Alirezagholizadehvazvani/industrial-motor-monitor/hardware/photos/01-complete-setup-failed-attempt.jpg

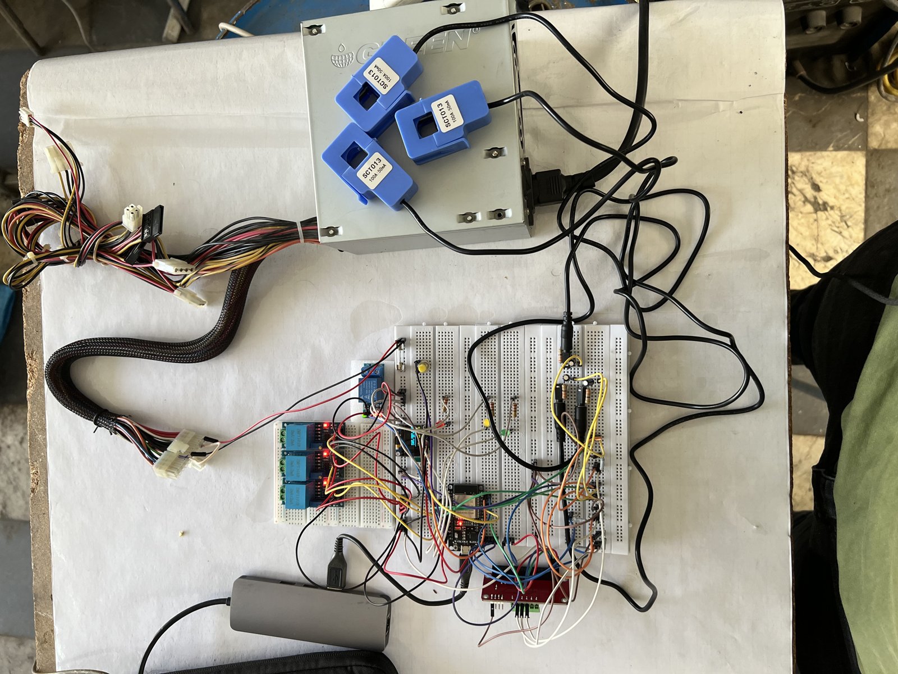
hardware/photos/01-complete-setup-failed-attempt.jpg
