Alirezagholizadehvazvani/industrial-motor-monitor/hardware/photos/01-socket-setup.jpg

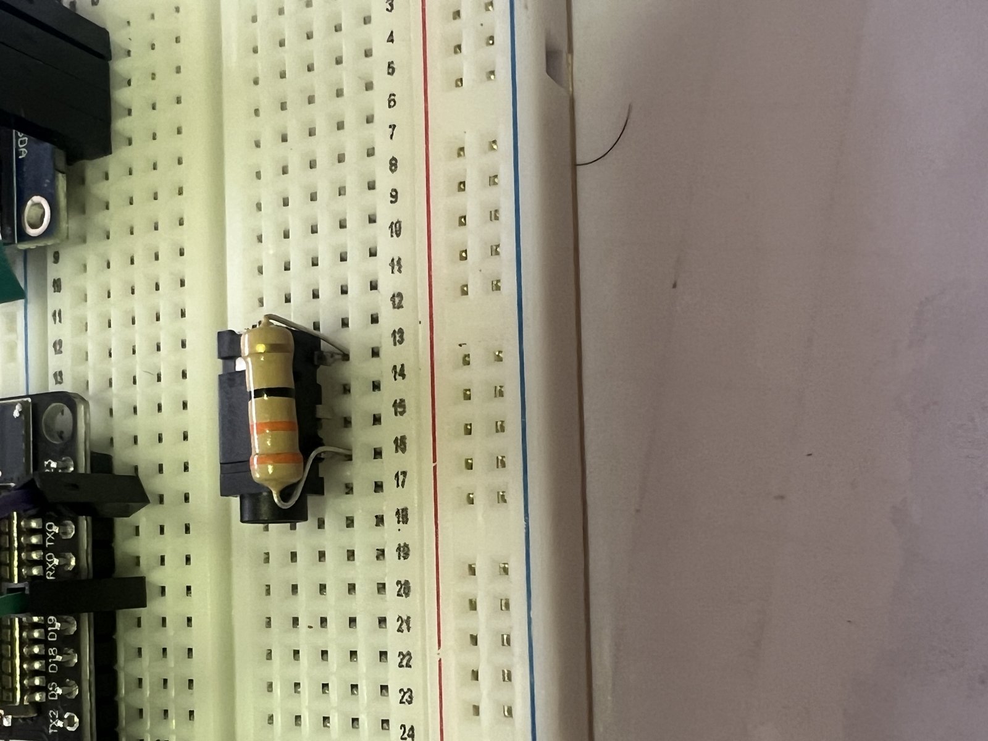
hardware/photos/01-socket-setup.jpg
