Alirezagholizadehvazvani/industrial-motor-monitor/hardware/photos/README.md

# Photos

Photos of the breadboard prototype and the enclosure during the build. Files are resized to 1600 px and carry no location data. The number prefixes come from the original file names. Dates were not recorded. Captions describe what is visible.

| File | Shows |
|---|---|
| `01-complete-setup-failed-attempt.jpg` | Breadboard build with the power supply and clamp-on current sensors, from the first attempt that did not work. |
| `01-components-boards.jpg` | Main boards: ESP32, relay module, three ZMPT101B modules, ADS1115 board and OLED. |
| `01-enclosure-cable-management.jpg` | Enclosure back plate with control wiring being organised. |
| `01-final-setup-failed.jpg` | Prototype wiring in the enclosure, version that failed. |
| `01-final-setup-fixed.jpg` | Breadboard prototype after the fix. |
| `01-new-wiring-method-fixed.jpg` | Breadboard rewired with the new method. The boxed area marks the changed section. |
| `01-noise-issue-fix.jpg` | Wiring in the enclosure while working on the noise problem. |
| `01-oled-test.jpg` | First bring-up of the OLED on the ESP32. |
| `01-phase0-failed-wiring.jpg` | Early breadboard wiring that did not work. |
| `01-power-circuit.jpg` | Power components on the DIN rail: breaker, starter and contactor. |
| `01-power-issue.jpg` | Power supply leads to the breadboard rails while tracing a power problem. |
| `01-sensor-readings-test.jpg` | OLED showing raw sensor readings. |
| `01-socket-setup.jpg` | Component fitted on the breadboard (sensor socket stage). |
| `01-status-test.jpg` | OLED showing STATUS: OK with current values. |
| `01-wiring-error.jpg` | Breadboard with the incorrect wiring areas marked in red. |
| `02-complete-setup-failed-attempt.jpg` | Second complete breadboard attempt with clamp-on sensors and the ADS1115 board. |
| `02-enclosure-cable-management.jpg` | Enclosure with the DIN rail components wired. |
| `02-power-circuit-contactor.jpg` | Hyundai HGC 25 contactor and the starter below it on the DIN rail. |
| `02-resistors.jpg` | Resistors, labelled by hand as 33 ohm 1 W, 220 ohm 2 W and 10 kohm 1 W. |
| `02-sensor-readings-test.jpg` | OLED showing three current-channel voltages of 1.56 V and three raw voltage-channel values. |
| `02-status-test.jpg` | OLED showing STATUS: OK. |
| `03-capacitors.jpg` | Capacitors, labelled by hand as 10 uF 25 V, 100 nF 400 V and 0.1 uF 50 V. |
| `03-status-test-tripped.jpg` | OLED showing STATUS: TRIPPED with the reset prompt, red LED on. |
