Alirezagholizadehvazvani/industrial-motor-monitor/hardware/photos/01-enclosure-cable-management.jpg

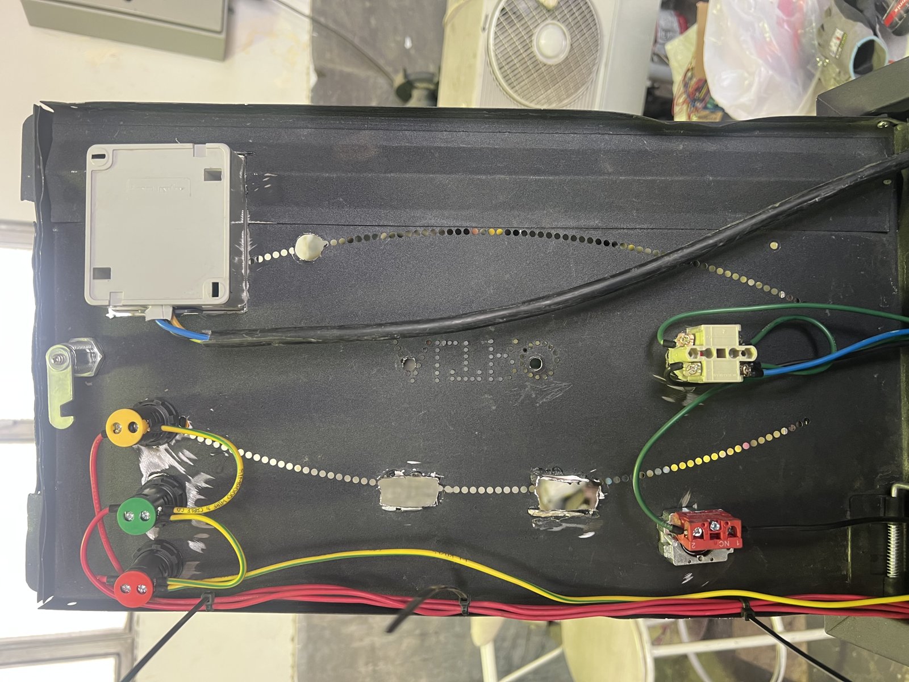
hardware/photos/01-enclosure-cable-management.jpg
