Alirezagholizadehvazvani/industrial-motor-monitor/hardware/photos/01-power-circuit.jpg

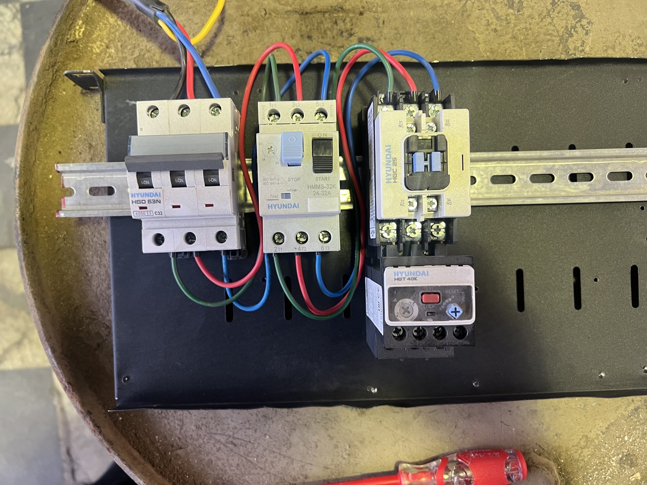
hardware/photos/01-power-circuit.jpg
