Alirezagholizadehvazvani/industrial-motor-monitor/hardware/photos/02-enclosure-cable-management.jpg

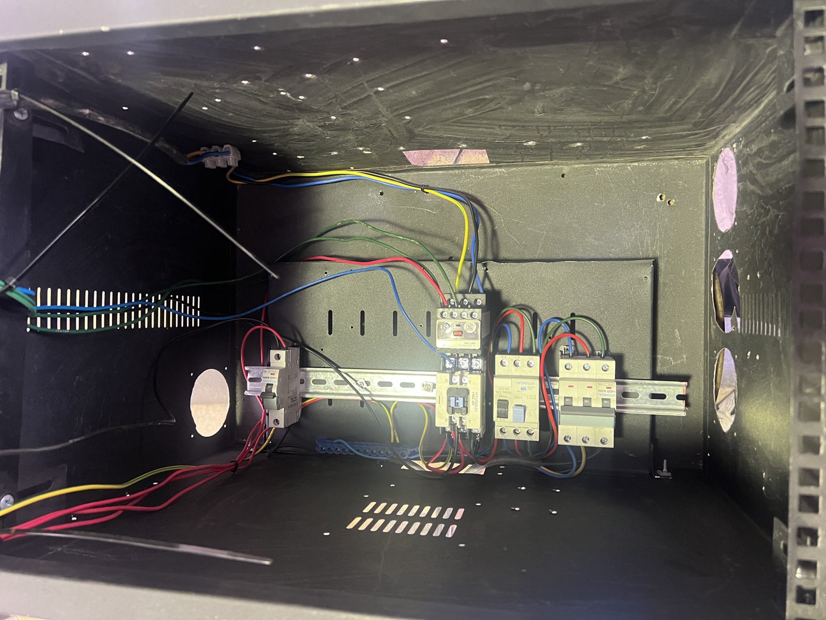
hardware/photos/02-enclosure-cable-management.jpg
