Alirezagholizadehvazvani/industrial-motor-monitor/hardware/photos/02-power-circuit-contactor.jpg

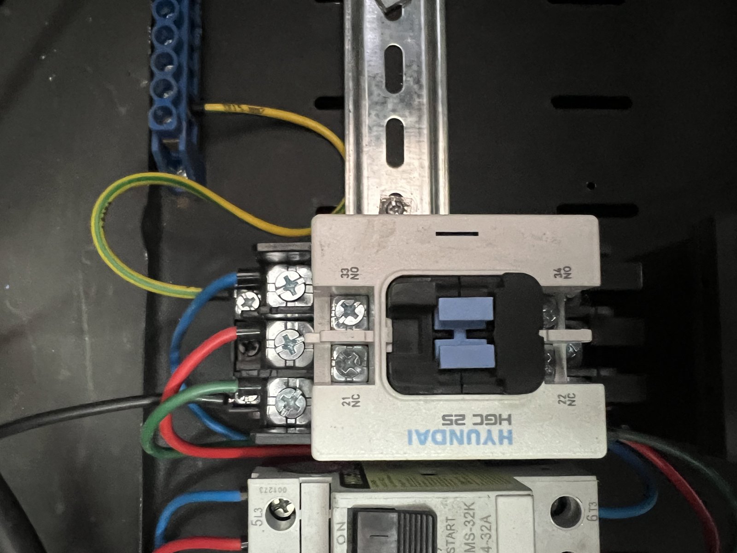
hardware/photos/02-power-circuit-contactor.jpg
