Alirezagholizadehvazvani/industrial-motor-monitor/hardware/photos/02-resistors.jpg

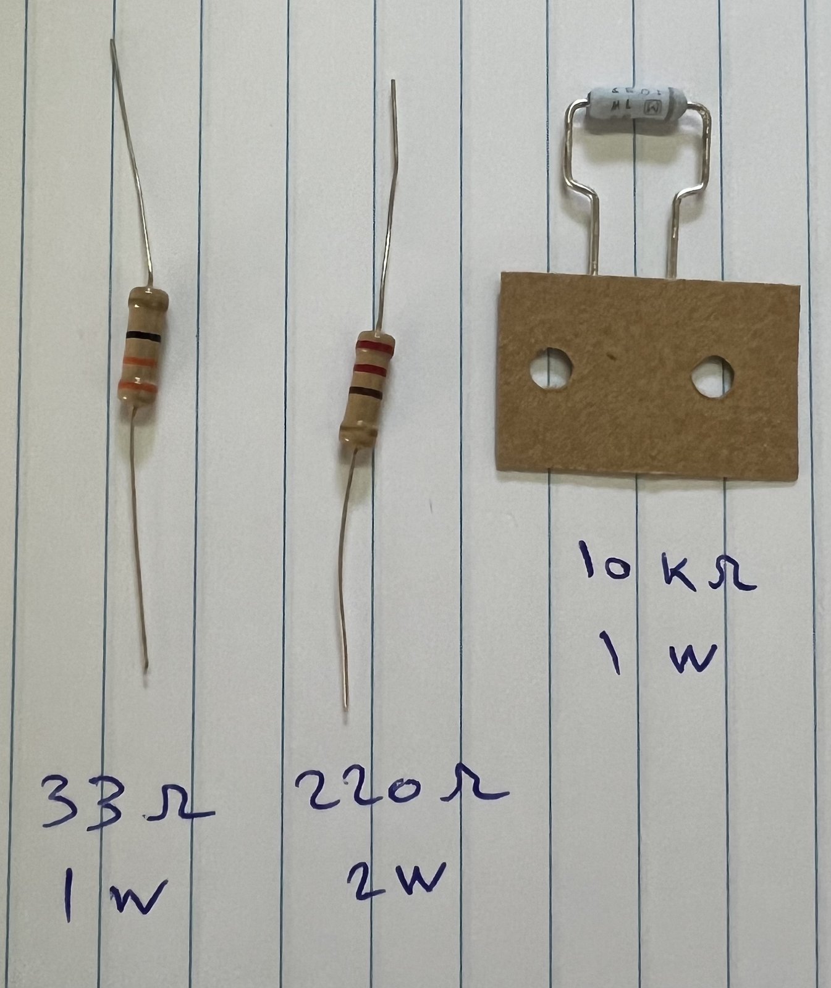
hardware/photos/02-resistors.jpg
