Alirezagholizadehvazvani/industrial-motor-monitor/hardware/photos/03-capacitors.jpg

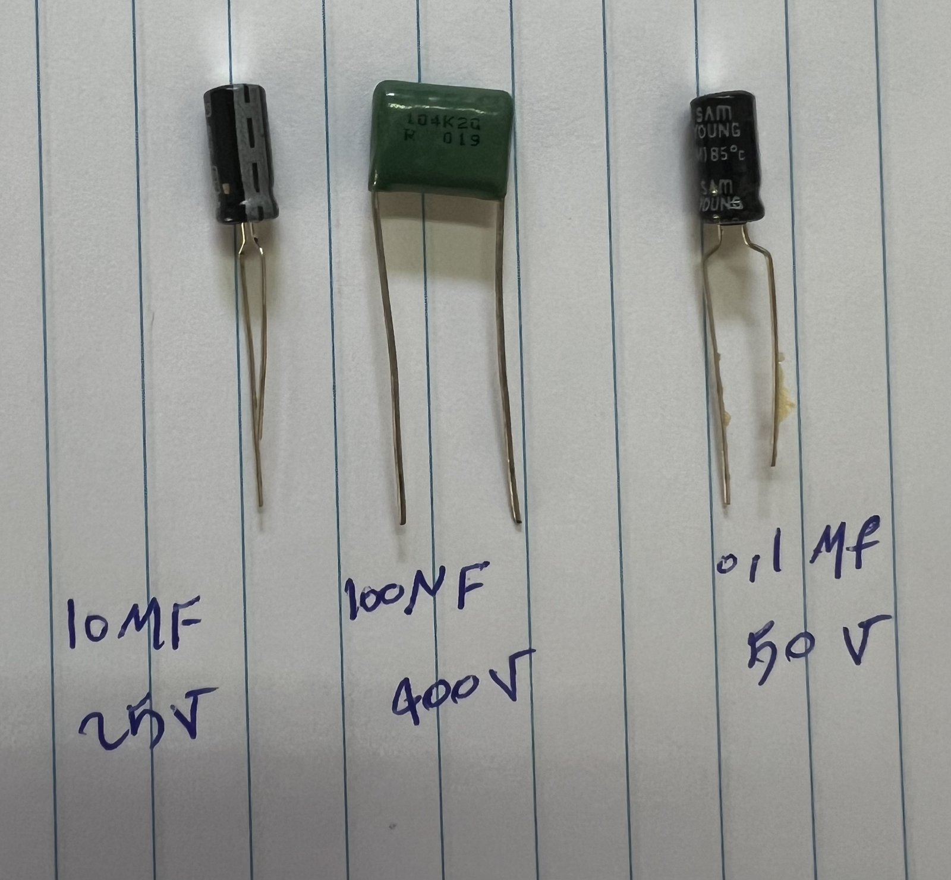
hardware/photos/03-capacitors.jpg
