Alirezagholizadehvazvani/industrial-motor-monitor/hardware/photos/01-components-boards.jpg

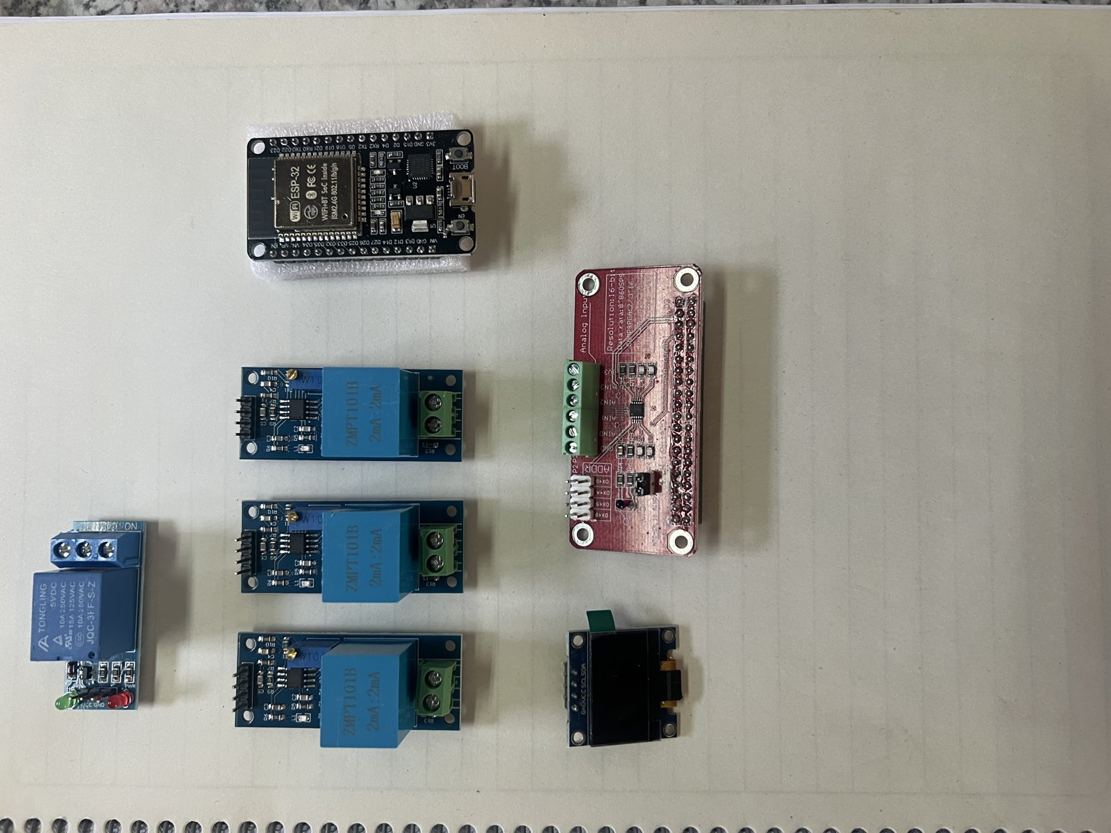
hardware/photos/01-components-boards.jpg
