Alirezagholizadehvazvani/industrial-motor-monitor/hardware/photos/01-final-setup-failed.jpg

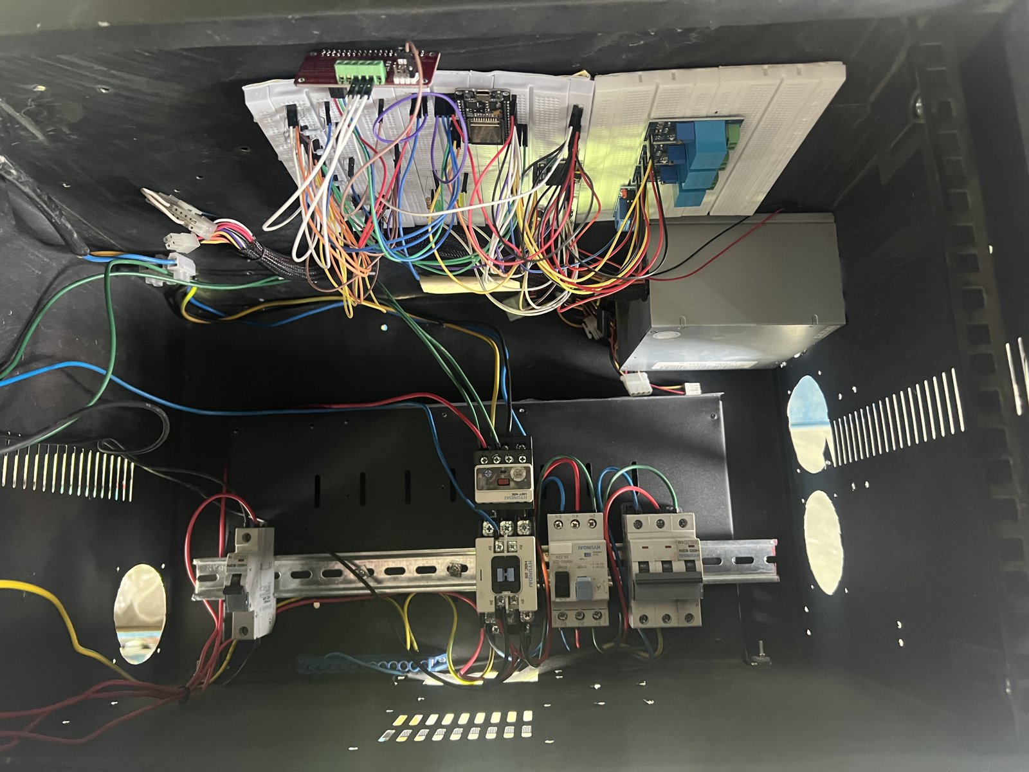
hardware/photos/01-final-setup-failed.jpg
