Alirezagholizadehvazvani/industrial-motor-monitor/hardware/photos/01-final-setup-fixed.jpg

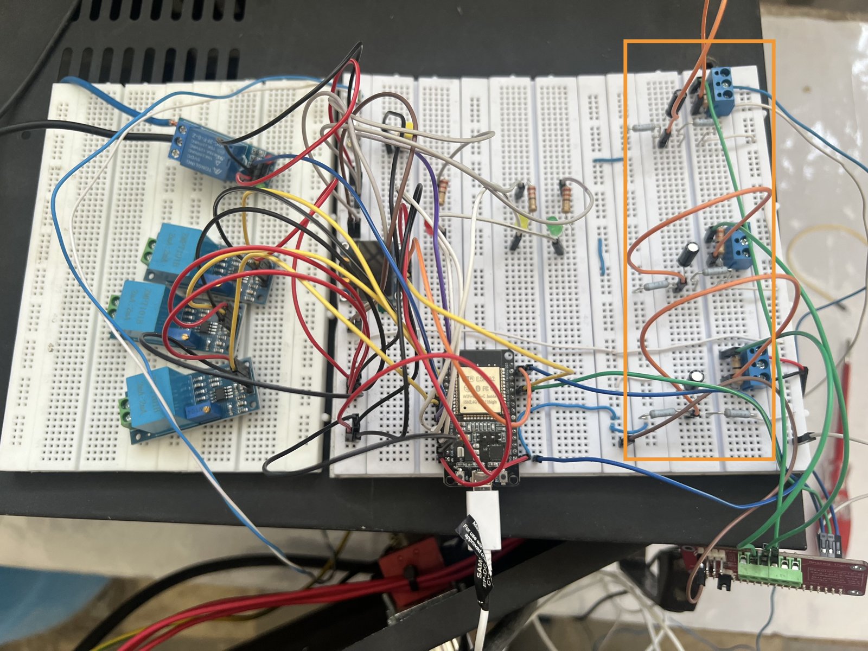
hardware/photos/01-final-setup-fixed.jpg
