Alirezagholizadehvazvani/industrial-motor-monitor/hardware/photos/01-new-wiring-method-fixed.jpg

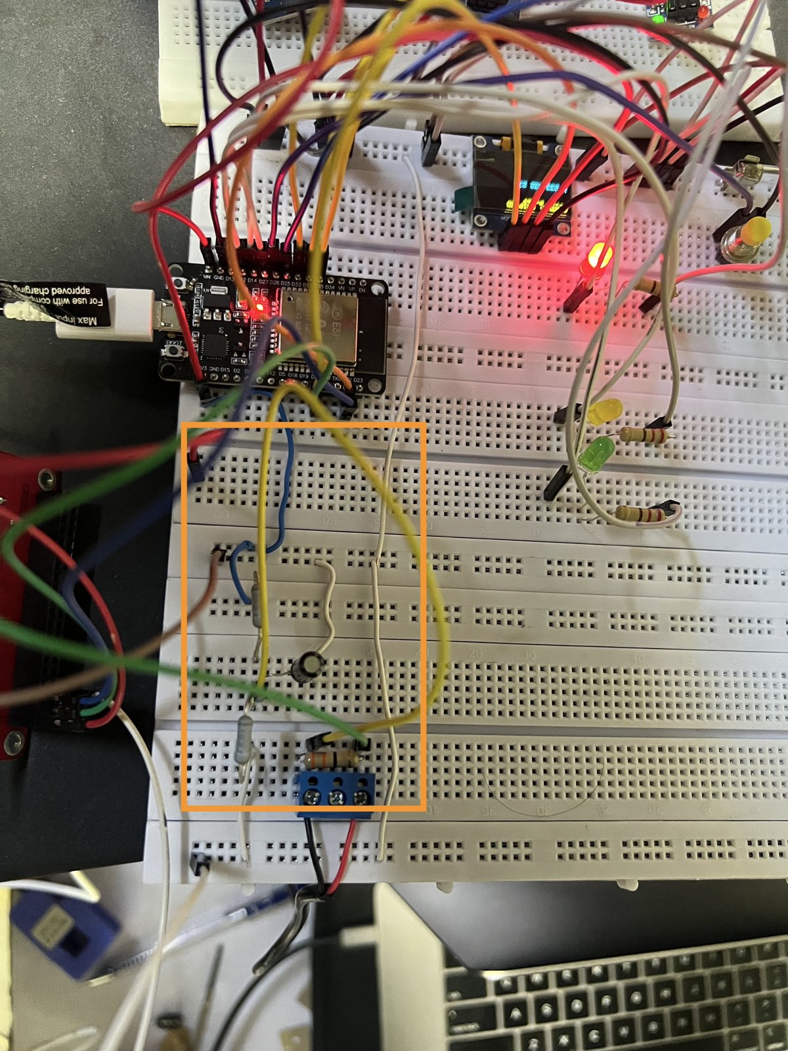
hardware/photos/01-new-wiring-method-fixed.jpg
