Alirezagholizadehvazvani/industrial-motor-monitor/hardware/photos/01-phase0-failed-wiring.jpg

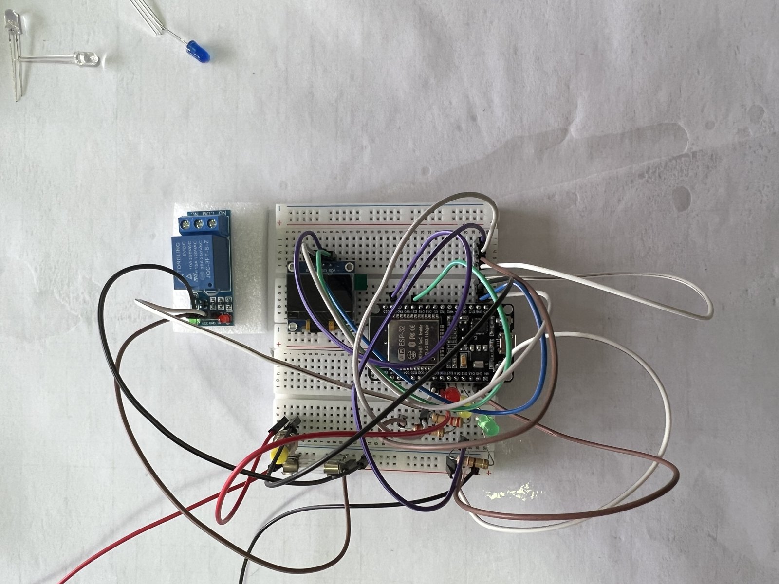
hardware/photos/01-phase0-failed-wiring.jpg
