Alirezagholizadehvazvani/industrial-motor-monitor/hardware/photos/01-wiring-error.jpg

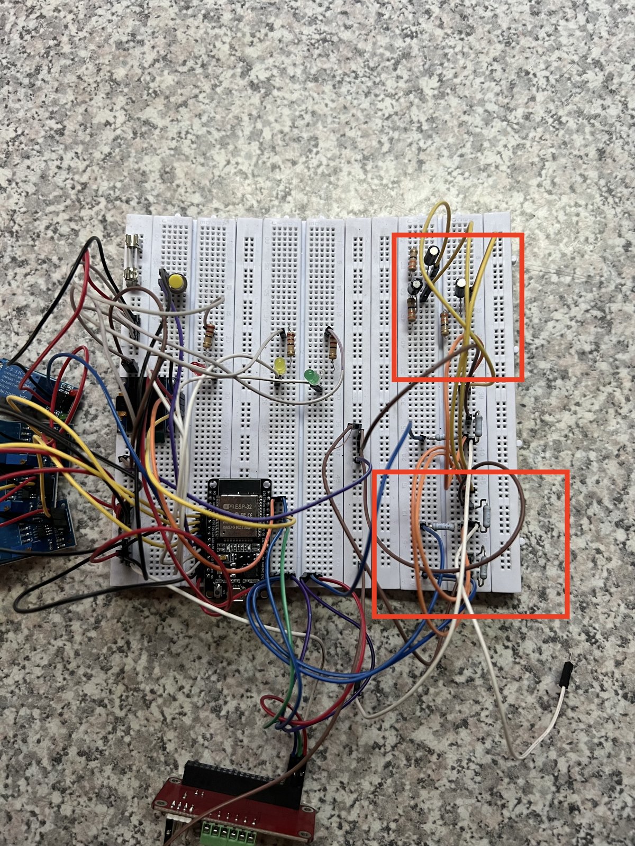
hardware/photos/01-wiring-error.jpg
