Alirezagholizadehvazvani/industrial-motor-monitor/hardware/photos/02-complete-setup-failed-attempt.jpg

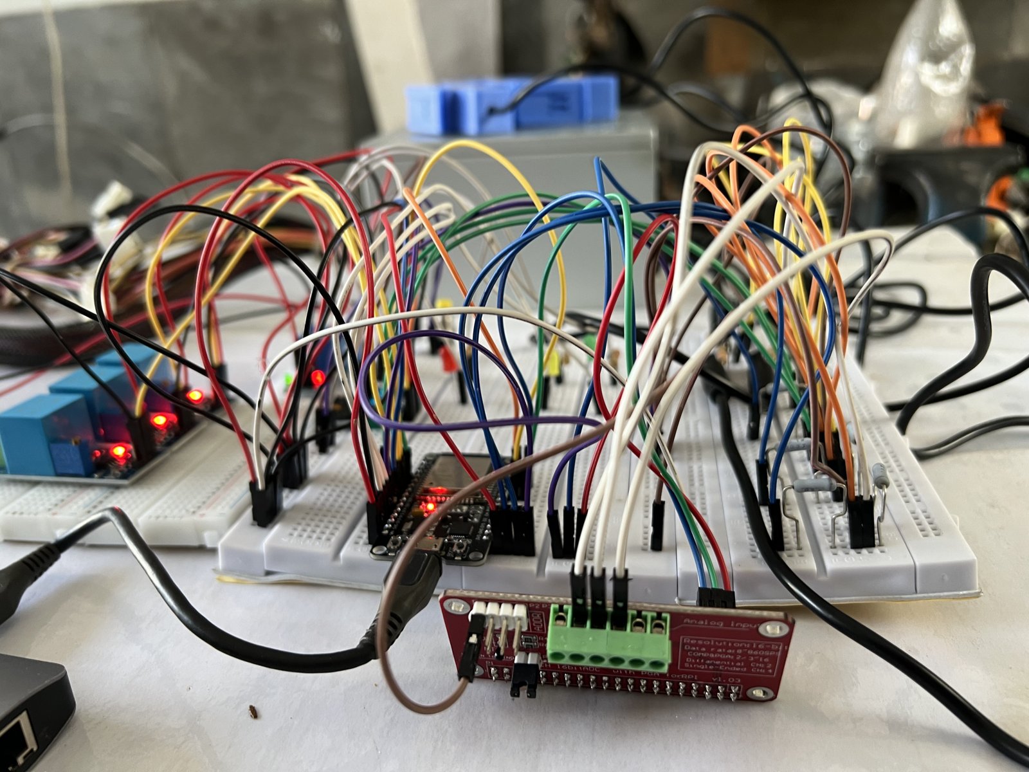
hardware/photos/02-complete-setup-failed-attempt.jpg
