Alirezagholizadehvazvani/industrial-motor-monitor/hardware/photos/01-oled-test.jpg

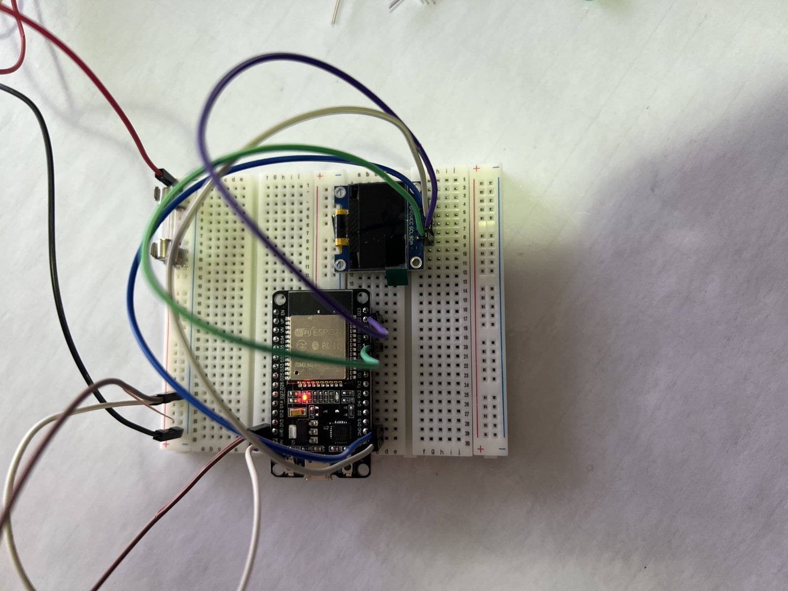
hardware/photos/01-oled-test.jpg
