Alirezagholizadehvazvani/industrial-motor-monitor/hardware/photos/01-sensor-readings-test.jpg

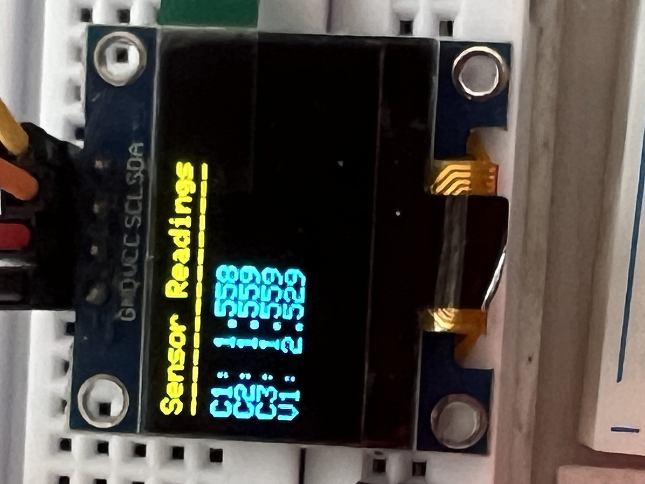
hardware/photos/01-sensor-readings-test.jpg
