Alirezagholizadehvazvani/industrial-motor-monitor/hardware/photos/01-status-test.jpg

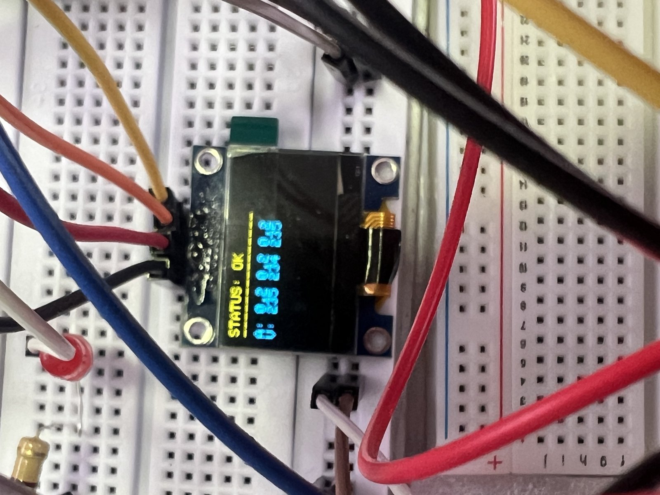
hardware/photos/01-status-test.jpg
