Alirezagholizadehvazvani/industrial-motor-monitor/hardware/photos/02-sensor-readings-test.jpg

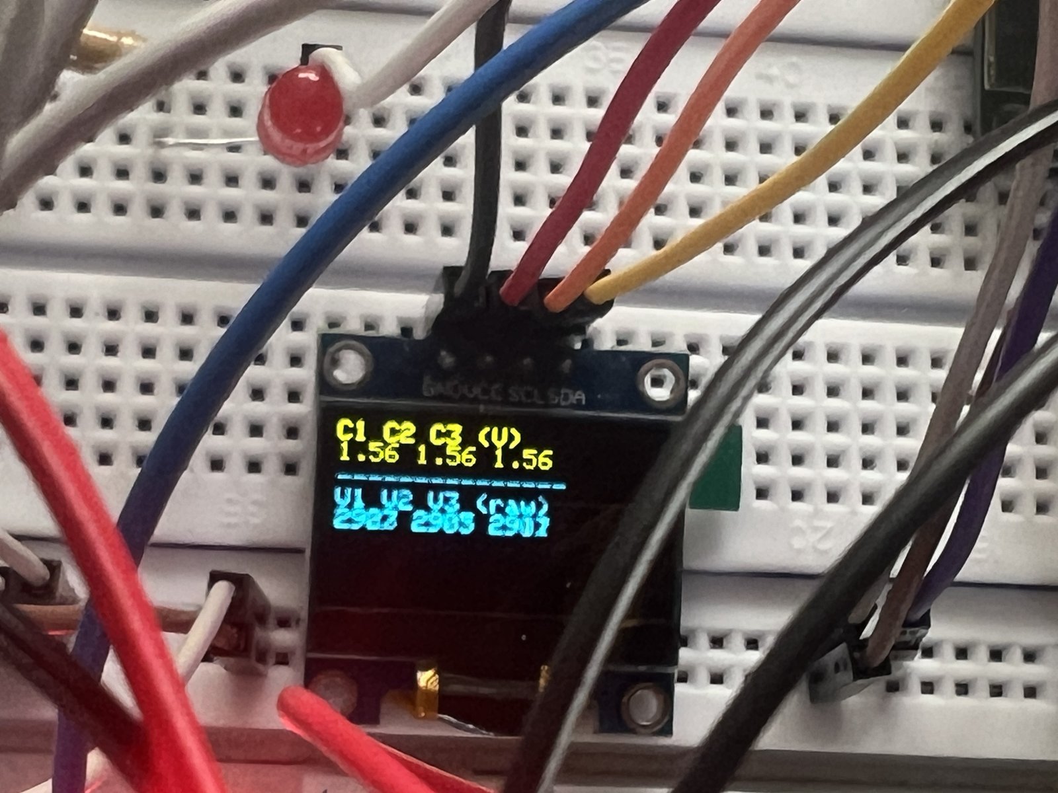
hardware/photos/02-sensor-readings-test.jpg
