Alirezagholizadehvazvani/industrial-motor-monitor/hardware/photos/02-status-test.jpg

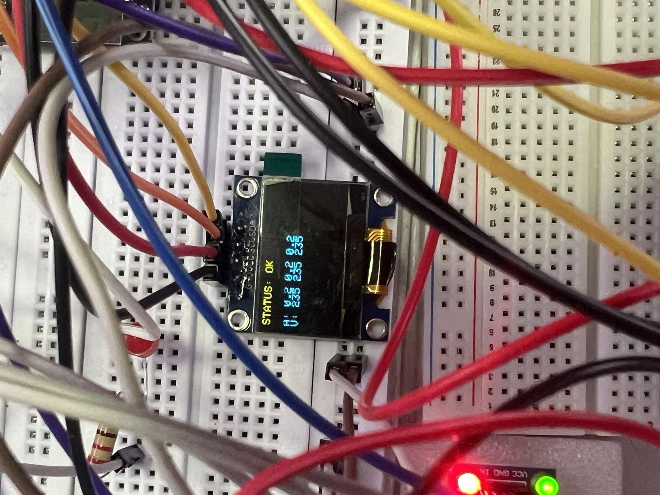
hardware/photos/02-status-test.jpg
