Alirezagholizadehvazvani/industrial-motor-monitor/hardware/photos/03-status-test-tripped.jpg

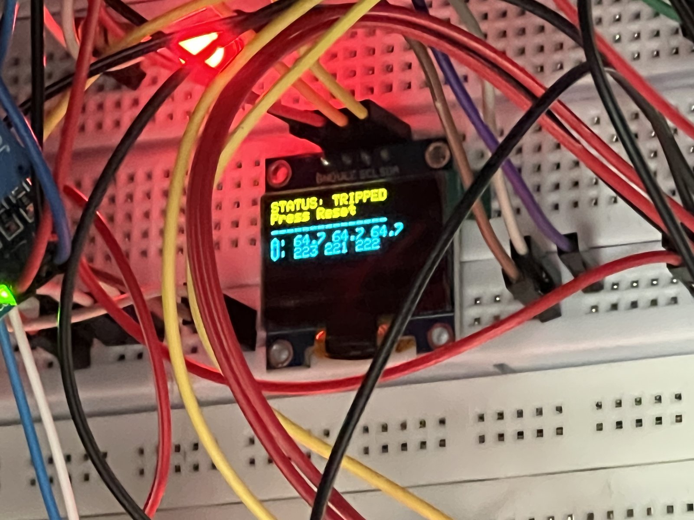
hardware/photos/03-status-test-tripped.jpg
