Alirezagholizadehvazvani/industrial-motor-monitor/hardware/photos/01-noise-issue-fix.jpg

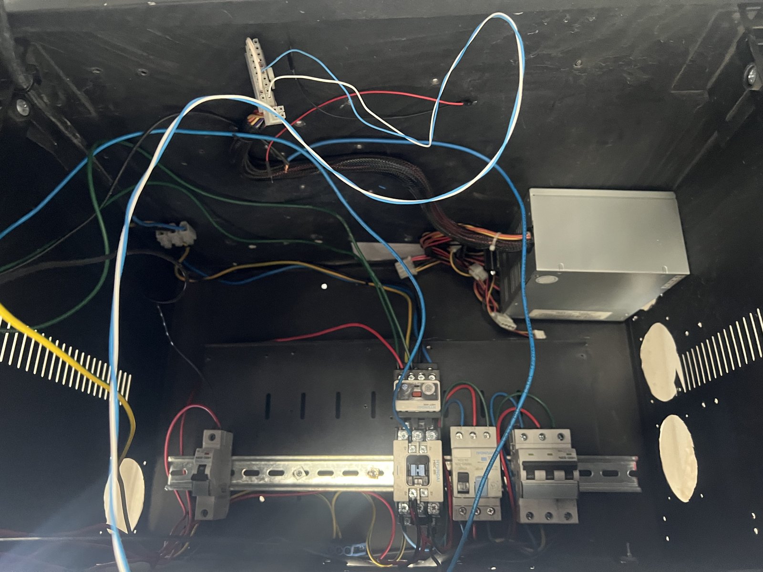
hardware/photos/01-noise-issue-fix.jpg
