Alirezagholizadehvazvani/industrial-motor-monitor/hardware/photos/01-power-issue.jpg

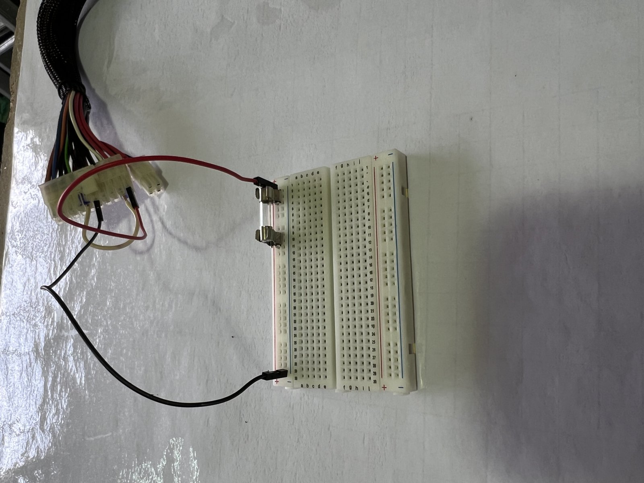
hardware/photos/01-power-issue.jpg
