Alirezagholizadehvazvani/industrial-motor-monitor/(commit log)

2026-10-07 Add hardware, assembly and safety documentation
2026-10-07 Rewrite README for current scope and add MIT license
2026-10-22 Add prototype photos, schematics, documents, and firmware
2026-10-25 Replace old firmware with new prototype sketch
    [main.prototype.ino]
2026-10-26 Document prototype hardware and bench testing
2026-10-27 Update industrial motor monitor documentation
